jwise/aWatch2-hw/awatch2.kicad_pcb

## KiCad design awatch2.kicad_pcb (2019-01-27)

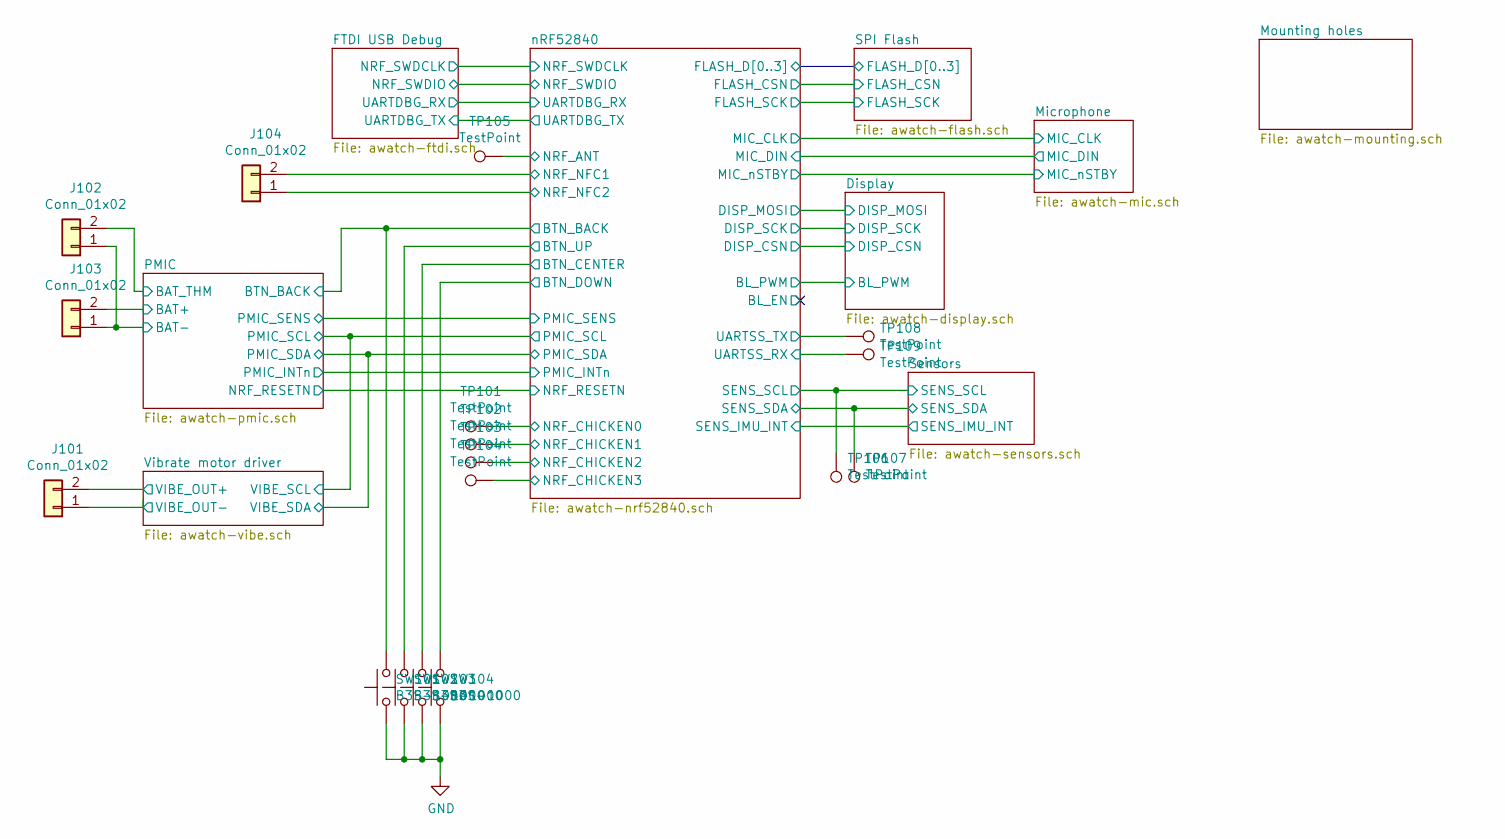
[picture p1: schematic awatch2.sch]

Parts:
J101, J102, J103, J104: Conn_01x02; PinHeader_1x02_P2.54mm_Vertical; DigiKey PN S1011EC-02-ND, S9341-ND
SW101, SW102, SW103, SW104: B3S-1000; SW_SPST_B3S-1000; DigiKey PN SW836CT-ND
TP101, TP102, TP103, TP104, TP105, TP106, TP107, TP108, TP109: TestPoint; TestPoint_Pad_D1.5mm

Connections:
/PMIC/BAT+: J103.2; also elsewhere on the board
/PMIC/BAT_THM: J102.2; also elsewhere on the board
/PMIC/BTN_BACK: SW101.2; also elsewhere on the board
/Sensors/SENS_SCL: TP106.1; also elsewhere on the board
/Sensors/SENS_SDA: TP107.1; also elsewhere on the board
/Vibrate motor driver/VIBE_OUT+: J101.2; also elsewhere on the board
/Vibrate motor driver/VIBE_OUT-: J101.1; also elsewhere on the board
/nRF52840/BTN_CENTER: SW103.2; also elsewhere on the board
/nRF52840/BTN_DOWN: SW104.2; also elsewhere on the board
/nRF52840/BTN_UP: SW102.2; also elsewhere on the board
/nRF52840/NRF_ANT: TP105.1; also elsewhere on the board
/nRF52840/NRF_CHICKEN0: TP101.1; also elsewhere on the board
/nRF52840/NRF_CHICKEN1: TP102.1; also elsewhere on the board
/nRF52840/NRF_CHICKEN2: TP103.1; also elsewhere on the board
/nRF52840/NRF_CHICKEN3: TP104.1; also elsewhere on the board
/nRF52840/NRF_NFC1: J104.2; also elsewhere on the board
/nRF52840/NRF_NFC2: J104.1; also elsewhere on the board
/nRF52840/UARTSS_RX: TP109.1; also elsewhere on the board
/nRF52840/UARTSS_TX: TP108.1; also elsewhere on the board
GND: J102.1, J103.1, SW101.1, SW102.1, SW103.1, SW104.1; also elsewhere on the board

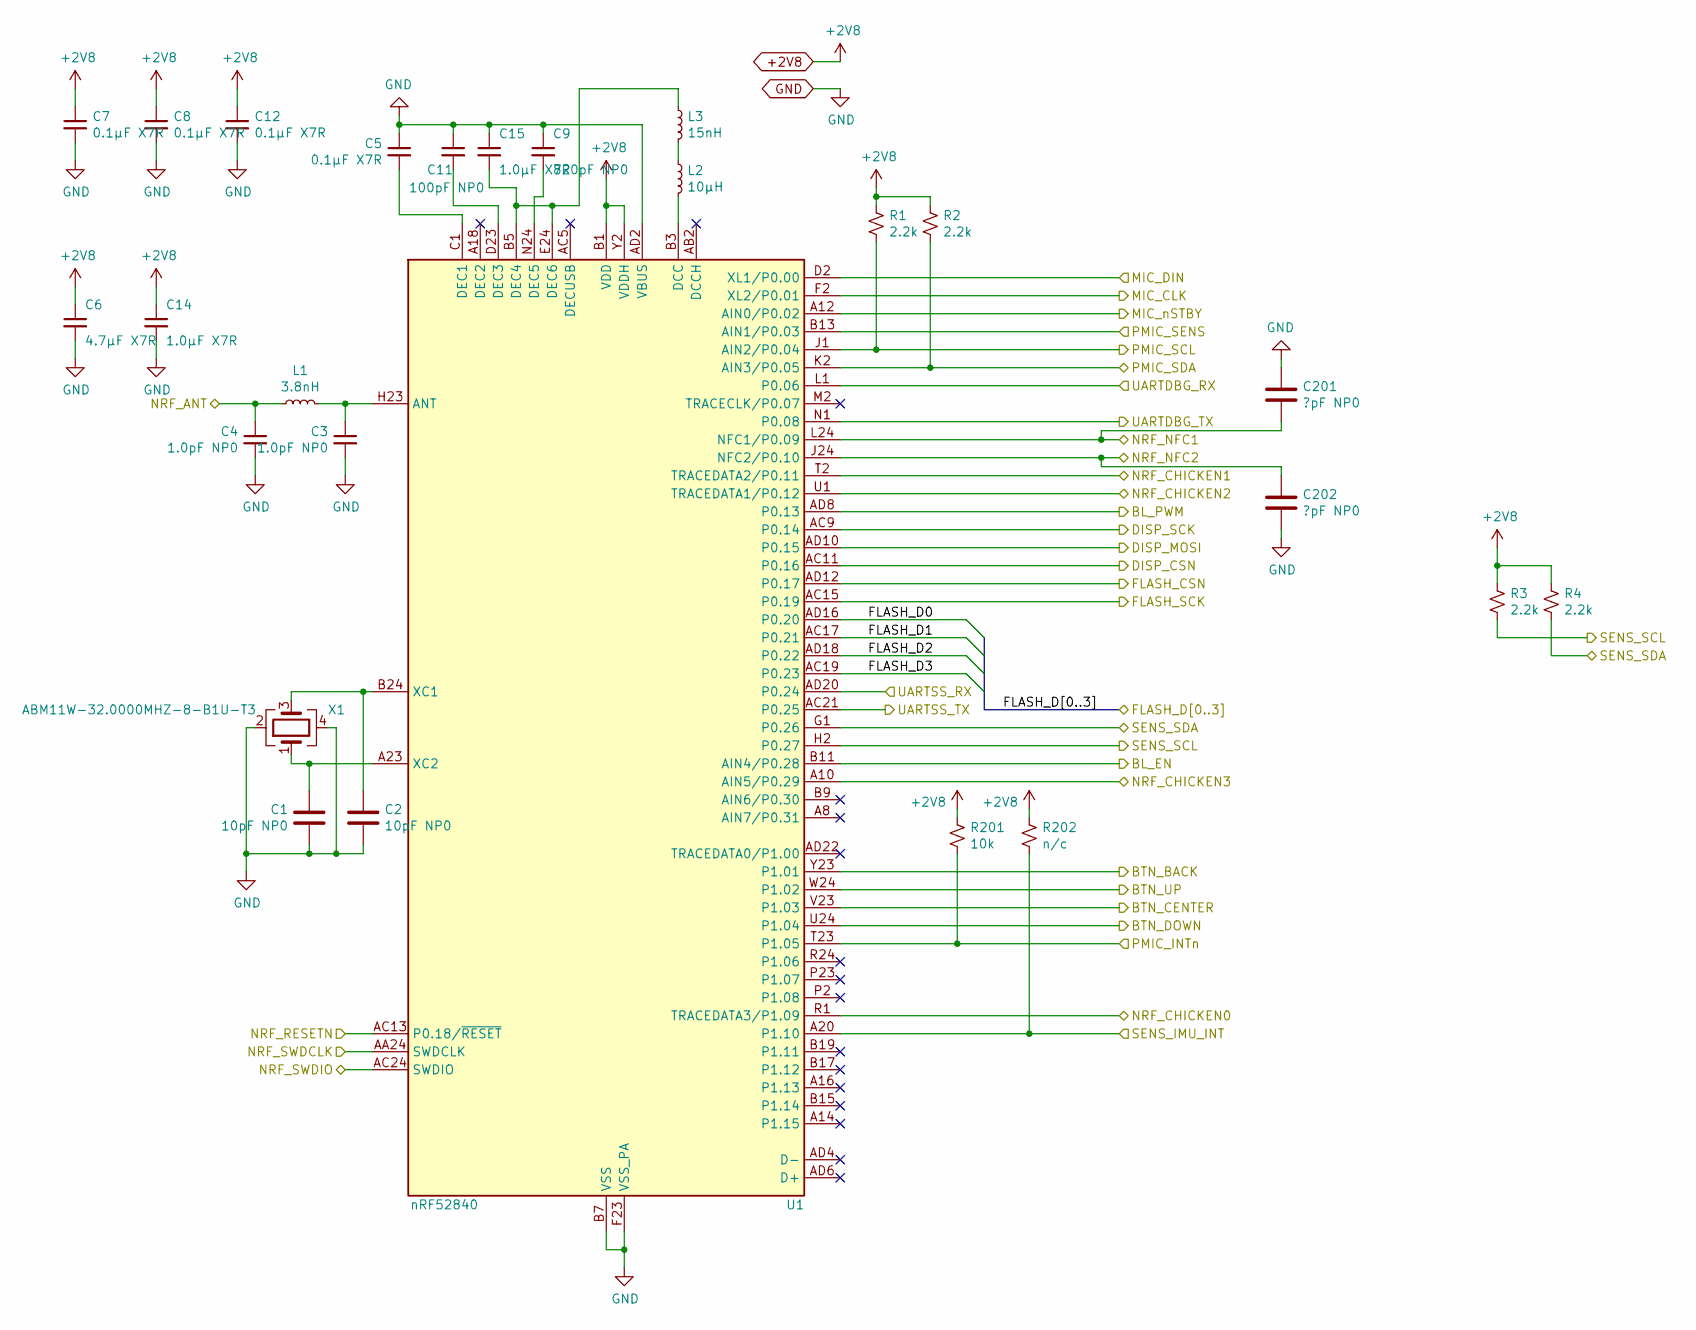
[picture p2: schematic awatch-nrf52840.sch, AWatch2]

Parts:
C1, C2: 10pF NP0; C_0603_1608Metric; DigiKey PN 311-3869-1-ND
C3, C4: 1.0pF NP0; C_0603_1608Metric; DigiKey PN 1276-1293-1-ND
C5, C7, C8, C12: 0.1µF X7R; C_0603_1608Metric; DigiKey PN 1276-1061-1-ND
C6: 4.7µF X7R; C_0603_1608Metric; DigiKey PN 1276-2087-1-ND
C9: 820pF NP0; C_0603_1608Metric; DigiKey PN 311-3959-1-ND
C11: 100pF NP0; C_0603_1608Metric; DigiKey PN 311-1069-1-ND
C14, C15: 1.0µF X7R; C_0603_1608Metric; DigiKey PN 1276-1946-1-ND
C201, C202: ?pF NP0; C_0603_1608Metric
L1: 3.8nH; L_0603_1608Metric; DigiKey PN 712-1429-1-ND
L2: 10µH; L_0603_1608Metric; DigiKey PN 445-6755-1-ND
L3: 15nH; L_0603_1608Metric; DigiKey PN CI160808-15NJCT-ND
R1, R2, R3, R4: 2.2k; R_0603_1608Metric; DigiKey PN MCT0603-2.20K-CFCT-ND
R201: 10k; R_0603_1608Metric; DigiKey PN MCT0603-10.0K-CFCT-ND
R202: n/c; R_0603_1608Metric
U1: nRF52840; Nordic_AQFN-73-1EP_7x7mm_P0.5mm; DigiKey PN 1490-1071-1-ND
X1: ABM11W-32.0000MHZ-8-B1U-T3; Crystal_SMD_2016-4Pin_2.0x1.6mm; DigiKey PN 535-13899-1-ND

Connections:
+2V8: C6.1, C7.1, C8.1, C12.1, C14.1, R1.1, R2.1, R3.1, R4.1, R201.1, R202.1, U1.A22 (VDD), U1.AD14 (VDD), U1.AD23 (VDD), U1.B1 (VDD), U1.W1 (VDD), U1.Y2 (VDDH); also elsewhere on the board
/Display/BL_PWM: U1.AD8 (P0.13); also elsewhere on the board
/Display/DISP_CSN: U1.AC11 (P0.16); also elsewhere on the board
/Display/DISP_MOSI: U1.AD10 (P0.15); also elsewhere on the board
/Display/DISP_SCK: U1.AC9 (P0.14); also elsewhere on the board
/FTDI USB Debug/NRF_SWDCLK: U1.AA24 (SWDCLK); also elsewhere on the board
/FTDI USB Debug/NRF_SWDIO: U1.AC24 (SWDIO); also elsewhere on the board
/FTDI USB Debug/UARTDBG_RX: U1.L1 (P0.06); also elsewhere on the board
/FTDI USB Debug/UARTDBG_TX: U1.N1 (P0.08); also elsewhere on the board
/Microphone/MIC_CLK: U1.F2 (XL2/P0.01); also elsewhere on the board
/Microphone/MIC_DIN: U1.D2 (XL1/P0.00); also elsewhere on the board
/Microphone/MIC_nSTBY: U1.A12 (AIN0/P0.02); also elsewhere on the board
/PMIC/BTN_BACK: U1.Y23 (P1.01); also elsewhere on the board
/PMIC/NRF_RESETN: U1.AC13 (P0.18/~RESET); also elsewhere on the board
/PMIC/PMIC_INTn: R201.2, U1.T23 (P1.05); also elsewhere on the board
/PMIC/PMIC_SCL: R1.2, U1.J1 (AIN2/P0.04); also elsewhere on the board
/PMIC/PMIC_SDA: R2.2, U1.K2 (AIN3/P0.05); also elsewhere on the board
/PMIC/PMIC_SENS: U1.B13 (AIN1/P0.03); also elsewhere on the board
/SPI Flash/FLASH_CSN: U1.AD12 (P0.17); also elsewhere on the board
/SPI Flash/FLASH_D0: U1.AD16 (P0.20); also elsewhere on the board
/SPI Flash/FLASH_D1: U1.AC17 (P0.21); also elsewhere on the board
/SPI Flash/FLASH_D2: U1.AD18 (P0.22); also elsewhere on the board
/SPI Flash/FLASH_D3: U1.AC19 (P0.23); also elsewhere on the board
/SPI Flash/FLASH_SCK: U1.AC15 (P0.19); also elsewhere on the board
/Sensors/SENS_IMU_INT: R202.2, U1.A20 (P1.10); also elsewhere on the board
/Sensors/SENS_SCL: R3.2, U1.H2 (P0.27); also elsewhere on the board
/Sensors/SENS_SDA: R4.2, U1.G1 (P0.26); also elsewhere on the board
/nRF52840/BL_EN: U1.B11 (AIN4/P0.28)
/nRF52840/BTN_CENTER: U1.V23 (P1.03); also elsewhere on the board
/nRF52840/BTN_DOWN: U1.U24 (P1.04); also elsewhere on the board
/nRF52840/BTN_UP: U1.W24 (P1.02); also elsewhere on the board
/nRF52840/NRF_ANT: C4.1, L1.1; also elsewhere on the board
/nRF52840/NRF_CHICKEN0: U1.R1 (TRACEDATA3/P1.09); also elsewhere on the board
/nRF52840/NRF_CHICKEN1: U1.T2 (TRACEDATA2/P0.11); also elsewhere on the board
/nRF52840/NRF_CHICKEN2: U1.U1 (TRACEDATA1/P0.12); also elsewhere on the board
/nRF52840/NRF_CHICKEN3: U1.A10 (AIN5/P0.29); also elsewhere on the board
/nRF52840/NRF_NFC1: C201.2, U1.L24 (NFC1/P0.09); also elsewhere on the board
/nRF52840/NRF_NFC2: C202.1, U1.J24 (NFC2/P0.10); also elsewhere on the board
/nRF52840/UARTSS_RX: U1.AD20 (P0.24); also elsewhere on the board
/nRF52840/UARTSS_TX: U1.AC21 (P0.25); also elsewhere on the board
GND: C1.2, C2.2, C3.2, C4.2, C5.1, C6.2, C7.2, C8.2, C9.1, C11.1, C12.2, C14.2, C15.1, C201.1, C202.2, U1.AD2 (VBUS), U1.B7 (VSS), U1.EP (VSS), U1.F23 (VSS_PA), X1.2, X1.4; also elsewhere on the board
unnamed: C1.1, U1.A23 (XC2), X1.1
unnamed: C2.1, U1.B24 (XC1), X1.3
unnamed: C3.1, L1.2, U1.H23 (ANT)
unnamed: C5.2, U1.C1 (DEC1)
unnamed: C9.2, U1.N24 (DEC5)
unnamed: C11.2, U1.D23 (DEC3)
unnamed: C15.2, L3.1, U1.B5 (DEC4), U1.E24 (DEC6)
unnamed: L2.1, L3.2
unnamed: L2.2, U1.B3 (DCC)

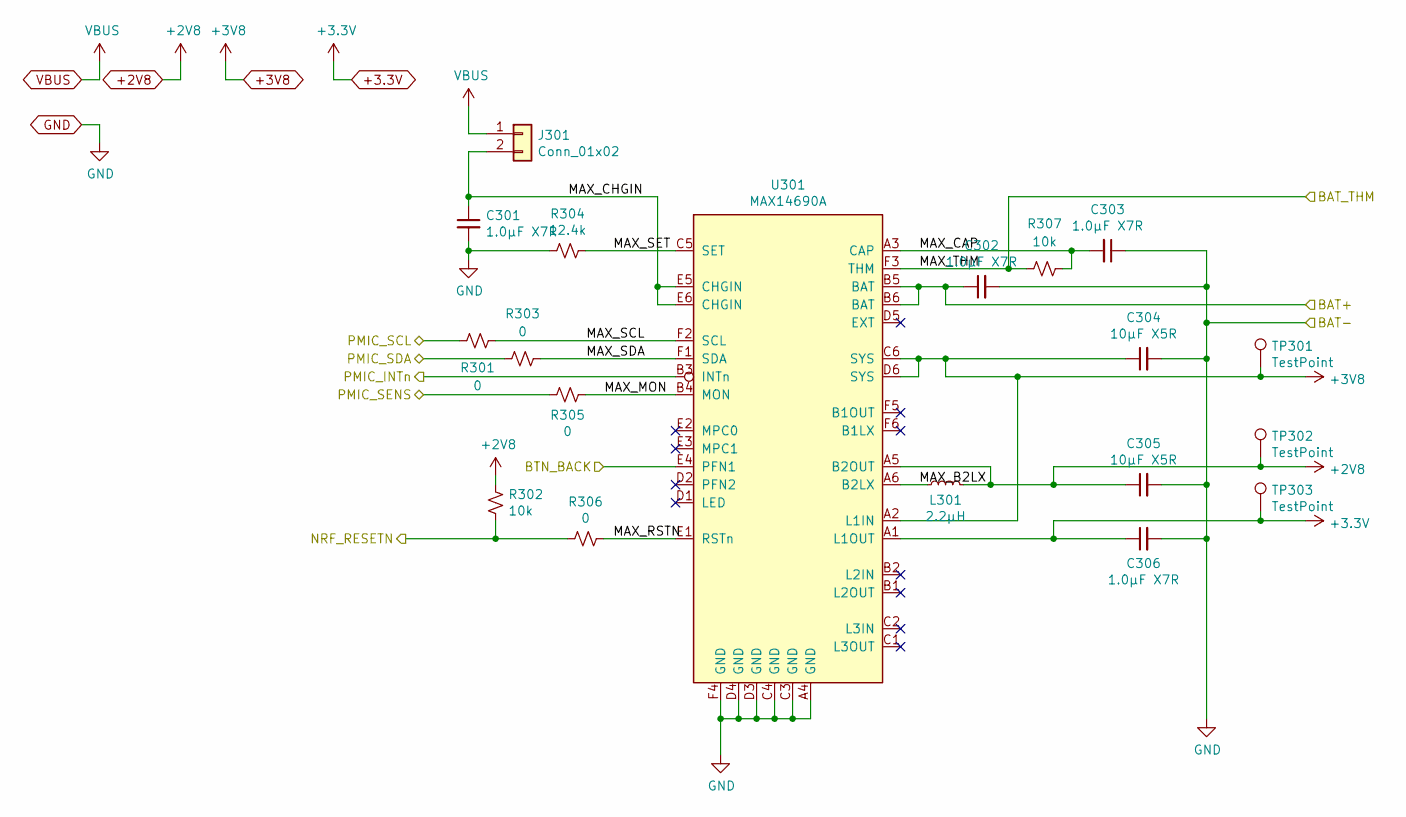
[picture p3: schematic awatch-pmic.sch, AWatch2]

Parts:
C301, C302, C303, C306: 1.0µF X7R; C_0603_1608Metric; DigiKey PN 1276-1946-1-ND
C304, C305: 10µF X5R; C_0603_1608Metric; DigiKey PN 490-12538-1-ND
J301: Conn_01x02; PinHeader_1x02_P2.54mm_Vertical; DigiKey PN S1011EC-02-ND, S9341-ND
L301: 2.2µH; L_0603_1608Metric; DigiKey PN 445-6385-1-ND
R301, R303, R305, R306: 0; R_0603_1608Metric; DigiKey PN MCT0603-0.0-ZZCT-ND
R302, R307: 10k; R_0603_1608Metric; DigiKey PN MCT0603-10.0K-CFCT-ND
R304: 12.4k; R_0603_1608Metric; DigiKey PN RNCP0603FTD12K4CT-ND
TP301, TP302, TP303: TestPoint; TestPoint_Pad_D1.5mm
U301: MAX14690A; WLP-36_2.69x2.44mm_Layout6x6_P0.4mm_Ball0.22mm_Pad0.2mm_NSMD; DigiKey PN MOUSER: 700-MAX14690AEWX+

Connections:
+2V8: C305.1, L301.2, R302.2, TP302.1, U301.A5 (B2OUT); also elsewhere on the board
+3.3V: C306.1, TP303.1, U301.A1 (L1OUT); also elsewhere on the board
+3V8: C304.1, TP301.1, U301.A2 (L1IN), U301.C6 (SYS), U301.D6 (SYS); also elsewhere on the board
/PMIC/BAT+: C302.1, U301.B5 (BAT), U301.B6 (BAT); also elsewhere on the board
/PMIC/BAT_THM: R307.2, U301.F3 (THM); also elsewhere on the board
/PMIC/BTN_BACK: U301.E4 (PFN1); also elsewhere on the board
/PMIC/MAX_B2LX: L301.1, U301.A6 (B2LX)
/PMIC/MAX_CAP: C303.2, R307.1, U301.A3 (CAP)
/PMIC/MAX_CHGIN: C301.1, J301.2, U301.E5 (CHGIN), U301.E6 (CHGIN)
/PMIC/MAX_MON: R305.1, U301.B4 (MON)
/PMIC/MAX_RSTN: R306.1, U301.E1 (RSTn)
/PMIC/MAX_SCL: R301.1, U301.F2 (SCL)
/PMIC/MAX_SDA: R303.1, U301.F1 (SDA)
/PMIC/MAX_SET: R304.1, U301.C5 (SET)
/PMIC/NRF_RESETN: R302.1, R306.2; also elsewhere on the board
/PMIC/PMIC_INTn: U301.B3 (INTn); also elsewhere on the board
/PMIC/PMIC_SCL: R301.2; also elsewhere on the board
/PMIC/PMIC_SDA: R303.2; also elsewhere on the board
/PMIC/PMIC_SENS: R305.2; also elsewhere on the board
GND: C301.2, C302.2, C303.1, C304.2, C305.2, C306.2, R304.2, U301.A4 (GND), U301.C3 (GND), U301.C4 (GND), U301.D3 (GND), U301.D4 (GND), U301.F4 (GND); also elsewhere on the board
VBUS: J301.1; also elsewhere on the board

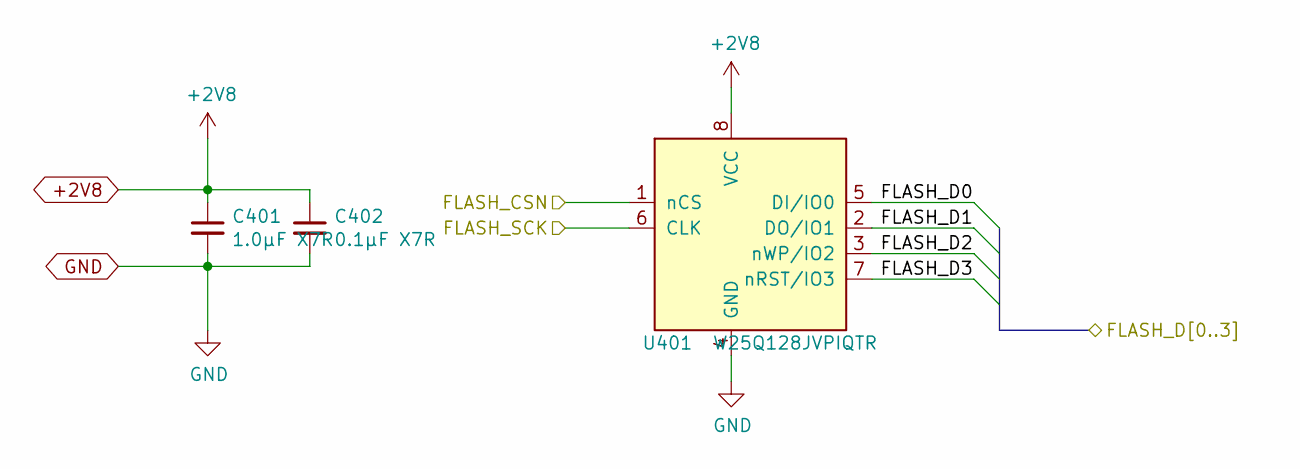
[picture p4: schematic awatch-flash.sch, AWatch2]

Parts:
C401: 1.0µF X7R; C_0603_1608Metric; DigiKey PN 1276-1946-1-ND
C402: 0.1µF X7R; C_0603_1608Metric; DigiKey PN 1276-1061-1-ND
U401: W25Q128JVPIQTR; WSON-8-1EP_6x5mm_P1.27mm_EP3.4x4mm; DigiKey PN W25Q128JVPIQCT-ND

Connections:
+2V8: C401.1, C402.1, U401.8 (VCC); also elsewhere on the board
/SPI Flash/FLASH_CSN: U401.1 (nCS); also elsewhere on the board
/SPI Flash/FLASH_D0: U401.5 (DI/IO0); also elsewhere on the board
/SPI Flash/FLASH_D1: U401.2 (DO/IO1); also elsewhere on the board
/SPI Flash/FLASH_D2: U401.3 (nWP/IO2); also elsewhere on the board
/SPI Flash/FLASH_D3: U401.7 (nRST/IO3); also elsewhere on the board
/SPI Flash/FLASH_SCK: U401.6 (CLK); also elsewhere on the board
GND: C401.2, C402.2, U401.4 (GND); also elsewhere on the board

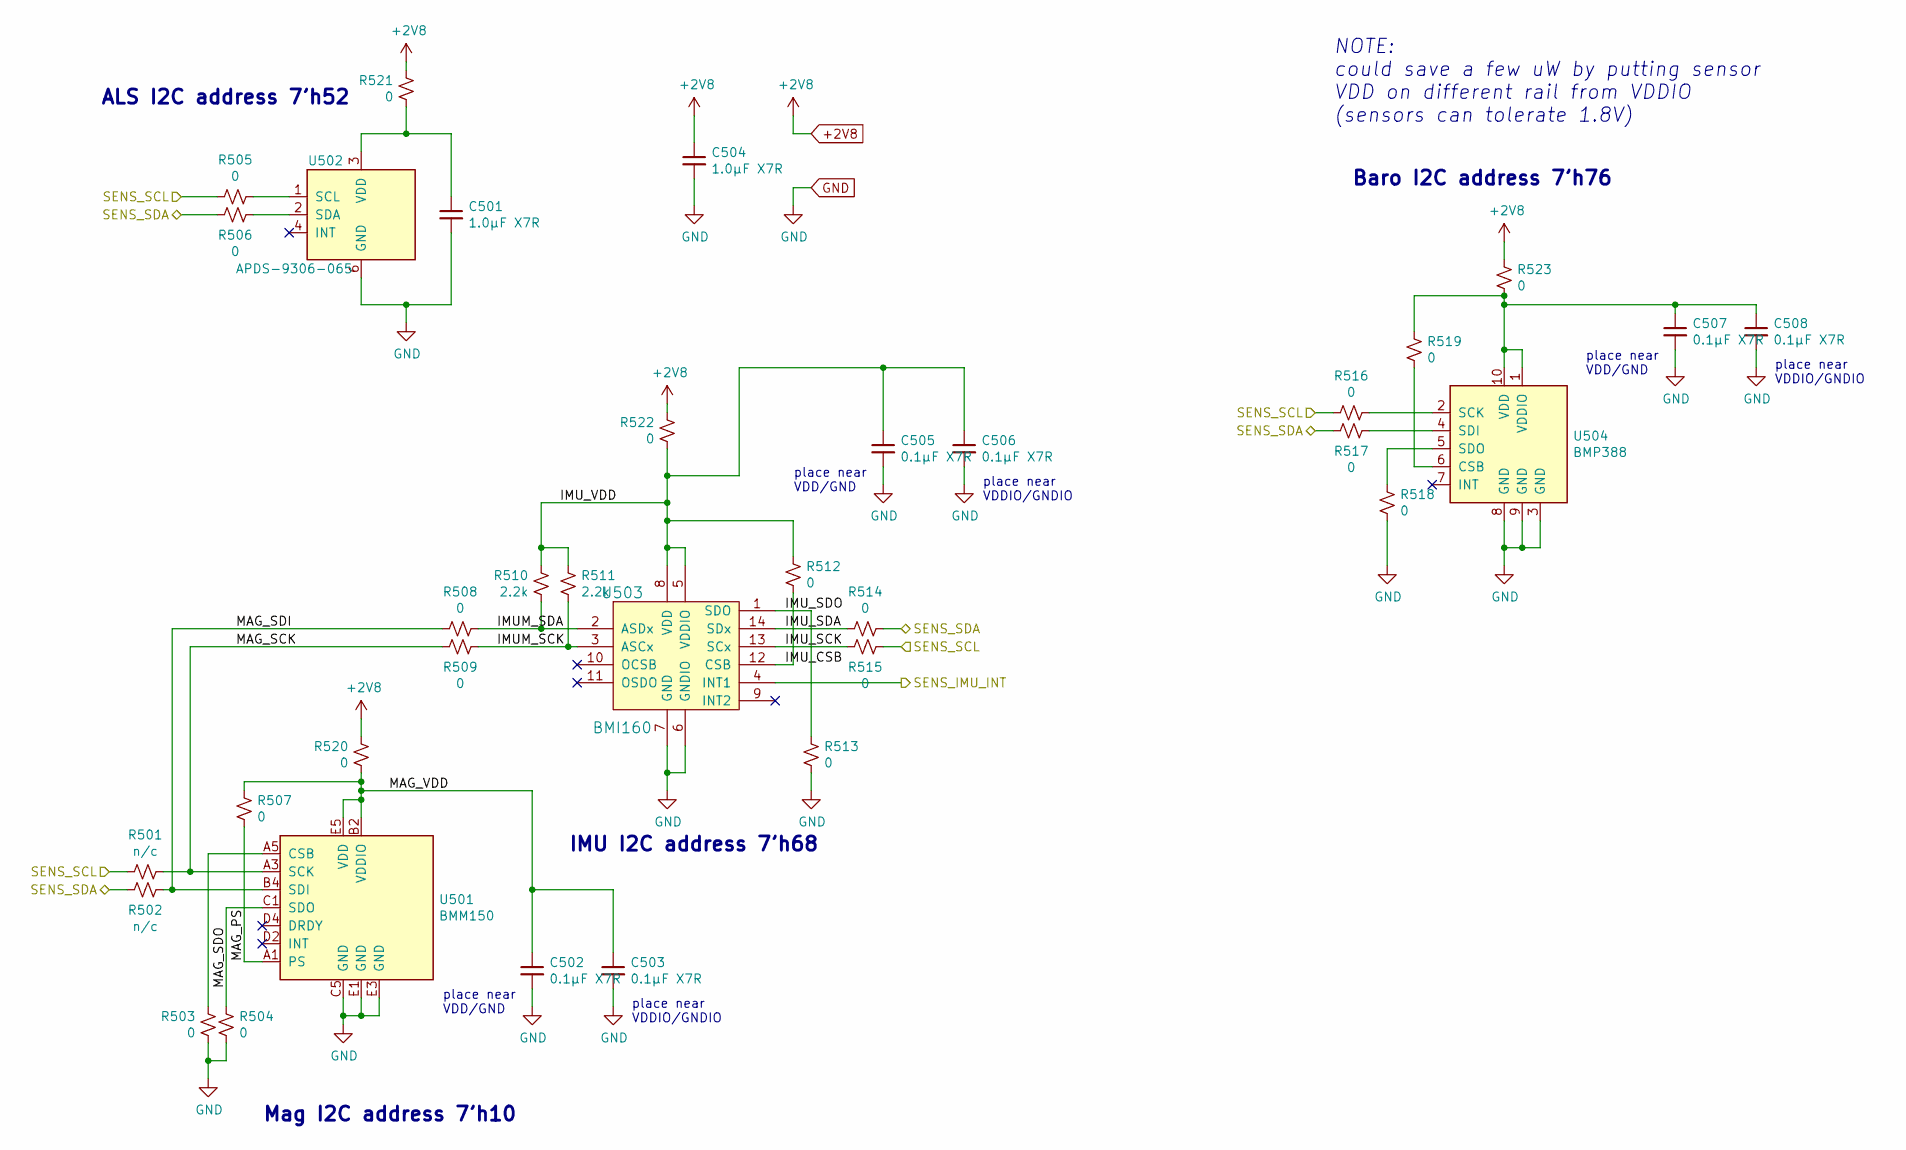
[picture p5: schematic awatch-sensors.sch, AWatch2]

Parts:
C501, C504: 1.0µF X7R; C_0603_1608Metric; DigiKey PN 1276-1946-1-ND
C502, C503, C505, C506, C507, C508: 0.1µF X7R; C_0603_1608Metric; DigiKey PN 1276-1061-1-ND
R501, R502: n/c; R_0603_1608Metric
R503, R504, R505, R506, R507, R508, R509, R512, R513, R514, R515, R516, R517, R518, R519, R520, R521, R522, R523: 0; R_0603_1608Metric; DigiKey PN MCT0603-0.0-ZZCT-ND
R510, R511: 2.2k; R_0603_1608Metric; DigiKey PN MCT0603-2.20K-CFCT-ND
U501: BMM150; WLCSP-12_1.56x1.56mm_Layout5x5_P0.283mm_Ball0.25mm_Pad0.2mm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; DigiKey PN 828-1044-1-ND
U502: APDS-9306-065; DFN-6_2x2mm_P0.53mm; DigiKey PN 516-3578-1-ND
U503: BMI160; DigiKey PN 828-1057-1-ND
U504: BMP388; DigiKey PN 828-1079-1-ND

Connections:
+2V8: C504.1, R520.2, R521.2, R522.2, R523.2; also elsewhere on the board
/Sensors/IMUM_SCK: R509.1, R511.2, U503.3 (ASCx)
/Sensors/IMUM_SDA: R508.1, R510.2, U503.2 (ASDx)
/Sensors/IMU_CSB: R512.1, U503.12 (CSB)
/Sensors/IMU_SCK: R515.2, U503.13 (SCx)
/Sensors/IMU_SDA: R514.2, U503.14 (SDx)
/Sensors/IMU_SDO: R513.2, U503.1 (SDO)
/Sensors/IMU_VDD: C505.1, C506.1, R510.1, R511.1, R512.2, R522.1, U503.5 (VDDIO), U503.8 (VDD)
/Sensors/MAG_PS: R507.1, U501.A1 (PS)
/Sensors/MAG_SCK: R501.1, R509.2, U501.A3 (SCK)
/Sensors/MAG_SDI: R502.1, R508.2, U501.B4 (SDI)
/Sensors/MAG_SDO: R504.2, U501.C1 (SDO)
/Sensors/MAG_VDD: C502.1, C503.1, R507.2, R520.1, U501.B2 (VDDIO), U501.E5 (VDD)
/Sensors/SENS_IMU_INT: U503.4 (INT1); also elsewhere on the board
/Sensors/SENS_SCL: R501.2, R505.2, R515.1, R516.2; also elsewhere on the board
/Sensors/SENS_SDA: R502.2, R506.2, R514.1, R517.2; also elsewhere on the board
GND: C501.2, C502.2, C503.2, C504.2, C505.2, C506.2, C507.2, C508.2, R503.1, R504.1, R513.1, R518.1, U501.C5 (GND), U501.E1 (GND), U501.E3 (GND), U502.6 (GND), U503.6 (GNDIO), U503.7 (GND), U504.3 (GND), U504.8 (GND), U504.9 (GND); also elsewhere on the board
unnamed: C501.1, R521.1, U502.3 (VDD)
unnamed: C507.1, C508.1, R519.2, R523.1, U504.1 (VDDIO), U504.10 (VDD)
unnamed: R503.2, U501.A5 (CSB)
unnamed: R505.1, U502.1 (SCL)
unnamed: R506.1, U502.2 (SDA)
unnamed: R516.1, U504.2 (SCK)
unnamed: R517.1, U504.4 (SDI)
unnamed: R518.2, U504.5 (SDO)
unnamed: R519.1, U504.6 (CSB)

Notes on the sheet:
ALS I2C address 7’h52
place near VDDIO/GNDIO
place near VDD/GND
Mag I2C address 7’h10
IMU I2C address 7’h68
Baro I2C address 7’h76
NOTE: could save a few uW by putting sensor VDD on different rail from VDDIO (sensors can tolerate 1.8V)

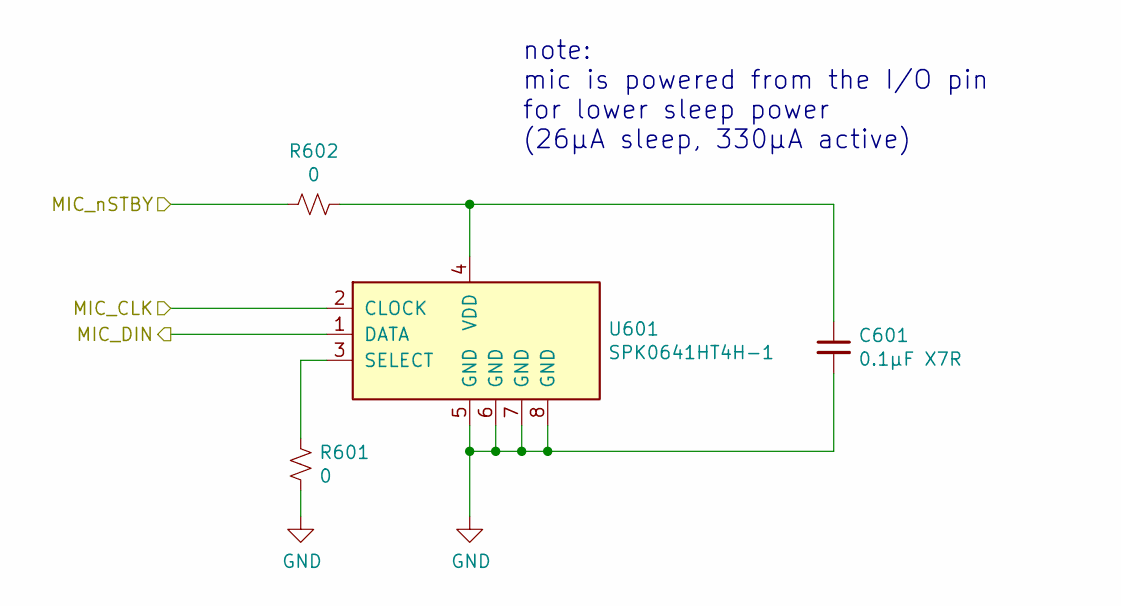
[picture p6: schematic awatch-mic.sch, AWatch2]

Parts:
C601: 0.1µF X7R; C_0603_1608Metric; DigiKey PN 1276-1061-1-ND
R601, R602: 0; R_0603_1608Metric; DigiKey PN MCT0603-0.0-ZZCT-ND
U601: SPK0641HT4H-1; SPK0641HT4H; DigiKey PN 423-1425-1-ND

Connections:
/Microphone/MIC_CLK: U601.2 (CLOCK); also elsewhere on the board
/Microphone/MIC_DIN: U601.1 (DATA); also elsewhere on the board
/Microphone/MIC_nSTBY: R602.2; also elsewhere on the board
GND: C601.2, R601.1, U601.5 (GND), U601.6 (GND), U601.7 (GND), U601.8 (GND); also elsewhere on the board
unnamed: C601.1, R602.1, U601.4 (VDD)
unnamed: R601.2, U601.3 (SELECT)

Notes on the sheet:
note: mic is powered from the I/O pin for lower sleep power (26µA sleep, 330µA active)

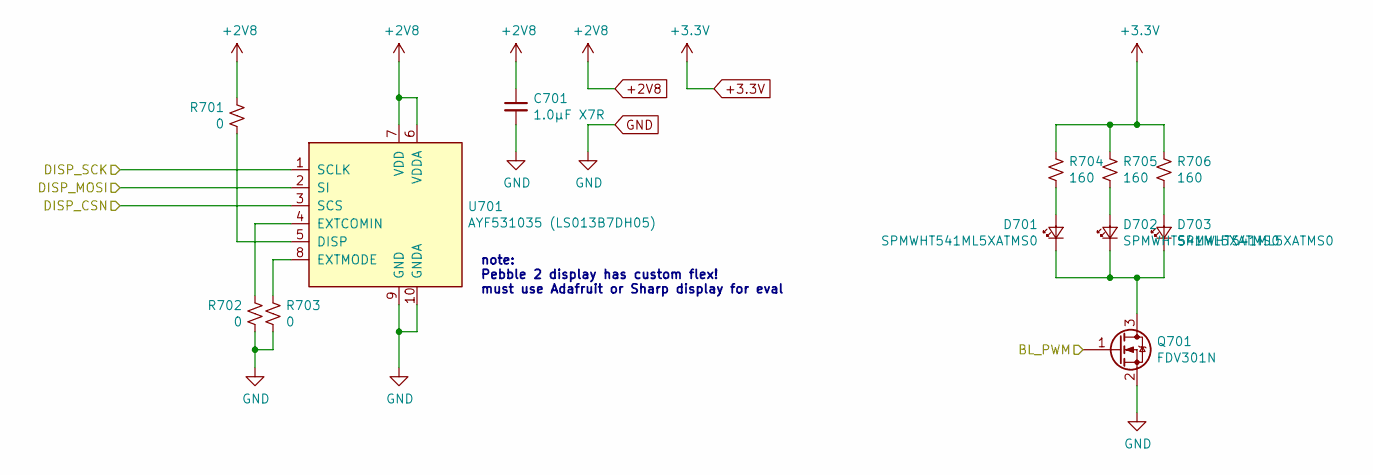
[picture p7: schematic awatch-display.sch, AWatch2]

Parts:
C701: 1.0µF X7R; C_0603_1608Metric; DigiKey PN 1276-1946-1-ND
D701, D702, D703: SPMWHT541ML5XATMS0; LED_PLCC_2835_Handsoldering; DigiKey PN 1510-1284-1-ND
Q701: FDV301N; SOT-23; DigiKey PN FDV301NCT-ND
R701, R702, R703: 0; R_0603_1608Metric; DigiKey PN MCT0603-0.0-ZZCT-ND
R704, R705, R706: 160; R_0603_1608Metric; DigiKey PN 749-1765-1-ND
U701: AYF531035 (LS013B7DH05); Panasonic_Y5B_AYF531035_1x10-1MP_P0.50mm_Horizontal; DigiKey PN 255-5667-ND, Adafruit display

Connections:
+2V8: C701.1, R701.1, U701.6 (VDDA), U701.7 (VDD); also elsewhere on the board
+3.3V: R704.1, R705.1, R706.1; also elsewhere on the board
/Display/BL_PWM: Q701.1 (G); also elsewhere on the board
/Display/DISP_CSN: U701.3 (SCS); also elsewhere on the board
/Display/DISP_MOSI: U701.2 (SI); also elsewhere on the board
/Display/DISP_SCK: U701.1 (SCLK); also elsewhere on the board
GND: C701.2, Q701.2 (S), R702.2, R703.2, U701.9 (GND), U701.10 (GNDA); also elsewhere on the board
unnamed: D701.1 (K), D702.1 (K), D703.1 (K), Q701.3 (D)
unnamed: D701.2 (A), R704.2
unnamed: D702.2 (A), R705.2
unnamed: D703.2 (A), R706.2
unnamed: R701.2, U701.5 (DISP)
unnamed: R702.1, U701.4 (EXTCOMIN)
unnamed: R703.1, U701.8 (EXTMODE)

Notes on the sheet:
note: Pebble 2 display has custom flex! must use Adafruit or Sharp display for eval

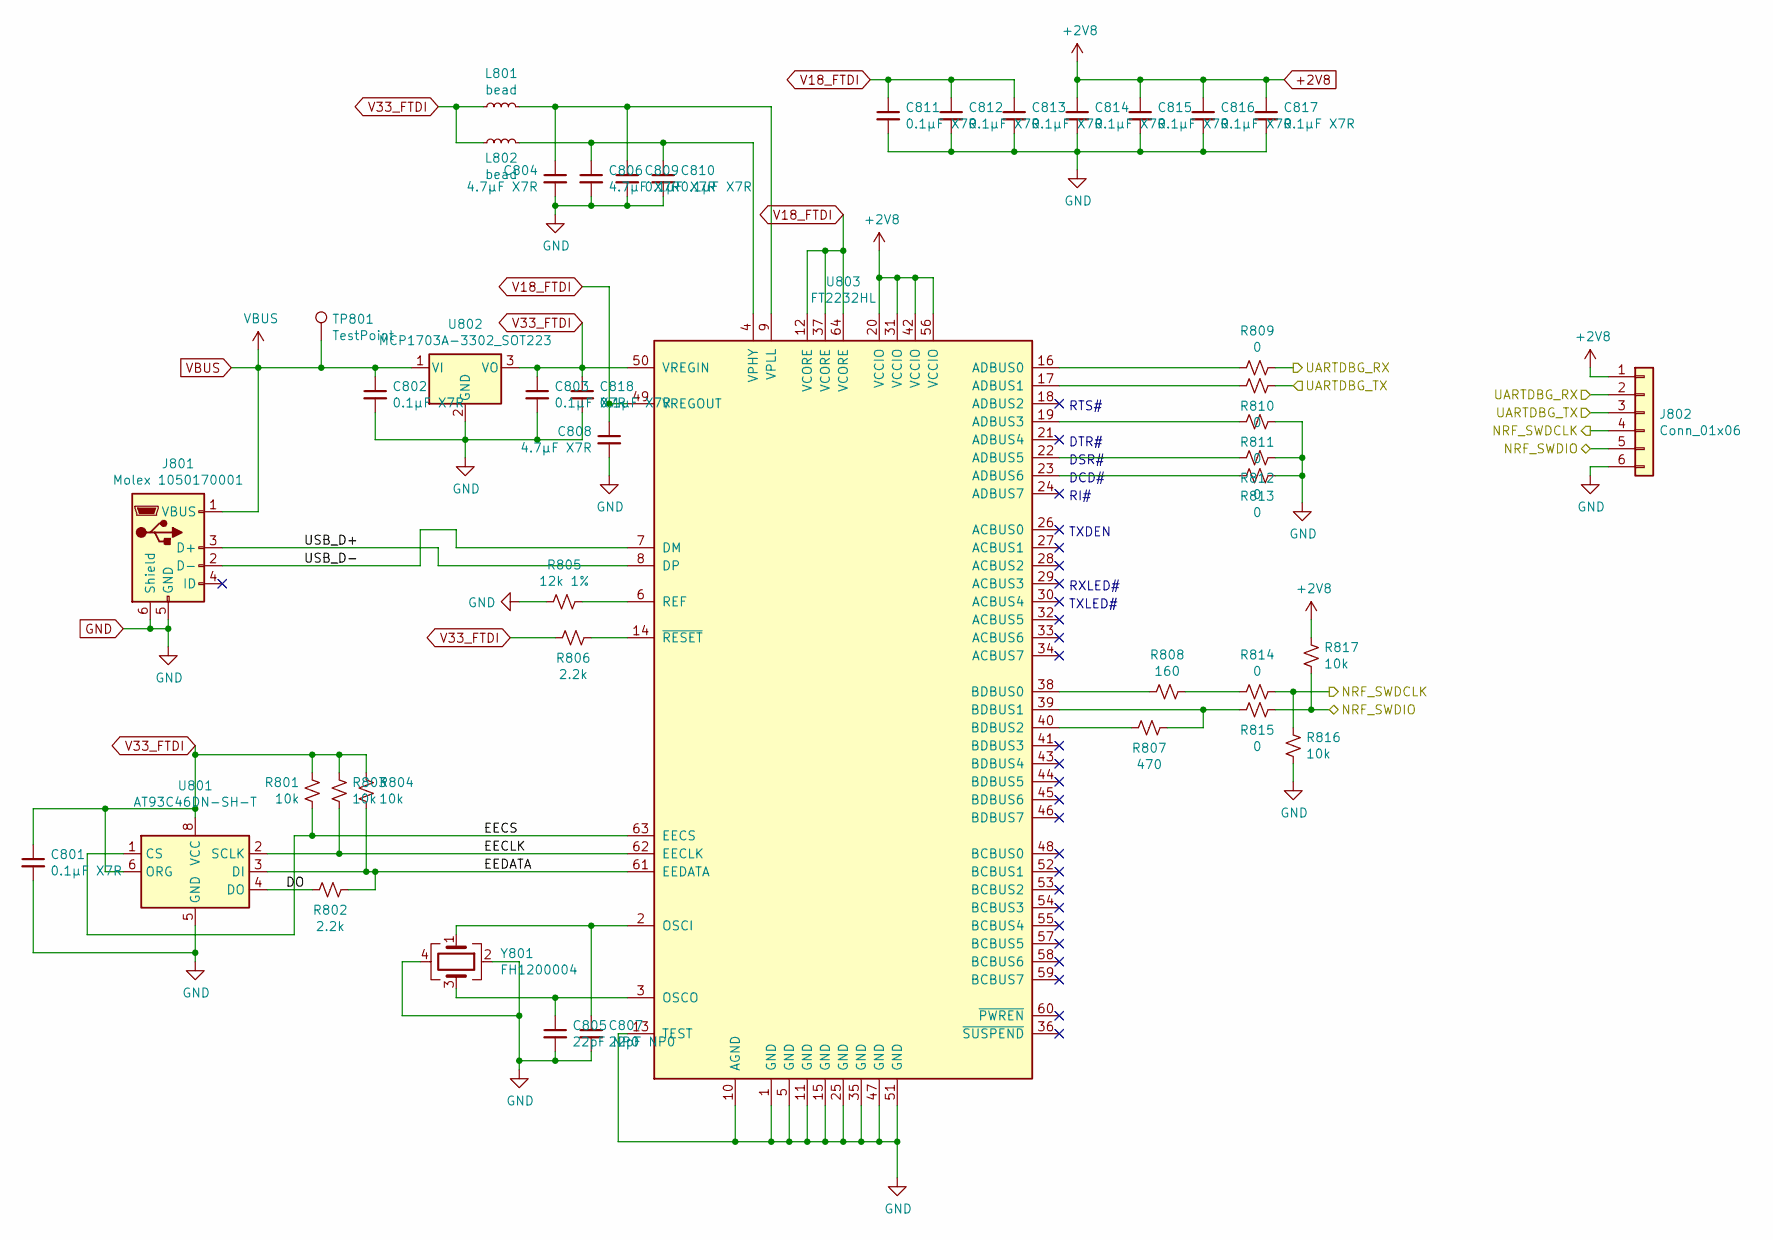
[picture p8: schematic awatch-ftdi.sch, AWatch2]

Parts:
C801, C802, C803, C809, C810, C811, C812, C813, C814, C815, C816, C817, C818: 0.1µF X7R; C_0603_1608Metric; DigiKey PN 1276-1061-1-ND
C804, C806, C808: 4.7µF X7R; C_0603_1608Metric; DigiKey PN 1276-2087-1-ND
C805, C807: 22pF NP0; C_0603_1608Metric; DigiKey PN 399-7874-1-ND
J801: Molex 1050170001; USB_Micro-B_Molex-105017-0001; DigiKey PN WM1399CT-ND
J802: Conn_01x06; PinHeader_1x06_P2.54mm_Vertical; DigiKey PN S1011EC-06-ND
L801, L802: bead; L_0603_1608Metric; DigiKey PN 587-1926-1-ND
R801, R803, R804, R816, R817: 10k; R_0603_1608Metric; DigiKey PN MCT0603-10.0K-CFCT-ND
R802, R806: 2.2k; R_0603_1608Metric; DigiKey PN MCT0603-2.20K-CFCT-ND
R805: 12k 1%; R_0603_1608Metric; DigiKey PN MCT0603-12.0K-CFCT-ND
R807: 470; R_0603_1608Metric; DigiKey PN MCT0603-470-CFCT-ND
R808: 160; R_0603_1608Metric; DigiKey PN 749-1765-1-ND
R809, R810, R811, R812, R813, R814, R815: 0; R_0603_1608Metric; DigiKey PN MCT0603-0.0-ZZCT-ND
TP801: TestPoint; TestPoint_Pad_D1.5mm
U801: AT93C46DN-SH-T; SOIC-8_3.9x4.9mm_P1.27mm; DigiKey PN AT93C46DN-SH-TCT-ND AT93C46DN-SH-TCT-ND
U802: MCP1703A-3302_SOT223; SOT-223-3_TabPin2; DigiKey PN MCP1703AT-3302E/DBCT-ND
U803: FT2232HL; LQFP-64_10x10mm_P0.5mm; DigiKey PN 768-1024-1-ND
Y801: FH1200004; Crystal_SMD_2520-4Pin_2.5x2.0mm; DigiKey PN FH1200004CT-ND

Connections:
+2V8: C814.1, C815.1, C816.1, C817.1, J802.1, R817.2, U803.20 (VCCIO), U803.31 (VCCIO), U803.42 (VCCIO), U803.56 (VCCIO); also elsewhere on the board
/FTDI USB Debug/DO: R802.2, U801.4 (DO)
/FTDI USB Debug/EECLK: R803.1, U801.2 (SCLK), U803.62 (EECLK)
/FTDI USB Debug/EECS: R801.1, U801.1 (CS), U803.63 (EECS)
/FTDI USB Debug/EEDATA: R802.1, R804.1, U801.3 (DI), U803.61 (EEDATA)
/FTDI USB Debug/NRF_SWDCLK: J802.4, R814.1, R816.2; also elsewhere on the board
/FTDI USB Debug/NRF_SWDIO: J802.5, R815.1, R817.1; also elsewhere on the board
/FTDI USB Debug/UARTDBG_RX: J802.2, R809.1; also elsewhere on the board
/FTDI USB Debug/UARTDBG_TX: J802.3, R810.1; also elsewhere on the board
/FTDI USB Debug/USB_D+: J801.3 (D+), U803.8 (DP)
/FTDI USB Debug/USB_D-: J801.2 (D-), U803.7 (DM)
GND: C801.2, C802.2, C803.2, C804.2, C805.2, C806.2, C807.2, C808.2, C809.2, C810.2, C811.2, C812.2, C813.2, C814.2, C815.2, C816.2, C817.2, C818.2, J801.5 (GND), J801.6 (Shield), J802.6, R805.1, R811.2, R812.2, R813.2, R816.1, U801.5 (GND), U802.2 (GND), U803.1 (GND), U803.5 (GND), U803.10 (AGND), U803.11 (GND), U803.13 (TEST), U803.15 (GND), U803.25 (GND), U803.35 (GND), U803.47 (GND), U803.51 (GND), Y801.2, Y801.4; also elsewhere on the board
unnamed: C804.1, C809.1, L801.2, U803.9 (VPLL)
unnamed: C805.1, U803.3 (OSCO), Y801.3
unnamed: C806.1, C810.1, L802.2, U803.4 (VPHY)
unnamed: C807.1, U803.2 (OSCI), Y801.1
unnamed: R805.2, U803.6 (REF)
unnamed: R806.2, U803.14 (~RESET)
unnamed: R807.1, R815.2, U803.39 (BDBUS1)
unnamed: R807.2, U803.40 (BDBUS2)
unnamed: R808.1, R814.2
unnamed: R808.2, U803.38 (BDBUS0)
unnamed: R809.2, U803.16 (ADBUS0)
unnamed: R810.2, U803.17 (ADBUS1)
unnamed: R811.1, U803.19 (ADBUS3)
unnamed: R812.1, U803.22 (ADBUS5)
unnamed: R813.1, U803.23 (ADBUS6)
V18_FTDI: C808.1, C811.1, C812.1, C813.1, U803.12 (VCORE), U803.37 (VCORE), U803.49 (VREGOUT), U803.64 (VCORE)
V33_FTDI: C801.1, C803.1, C818.1, L801.1, L802.1, R801.2, R803.2, R804.2, R806.1, U801.6 (ORG), U801.8 (VCC), U802.3 (VO), U803.50 (VREGIN)
VBUS: C802.1, J801.1 (VBUS), TP801.1, U802.1 (VI); also elsewhere on the board

Notes on the sheet:
RTS#
DTR#
DSR#
DCD#
RI#
TXDEN
RXLED#
TXLED#

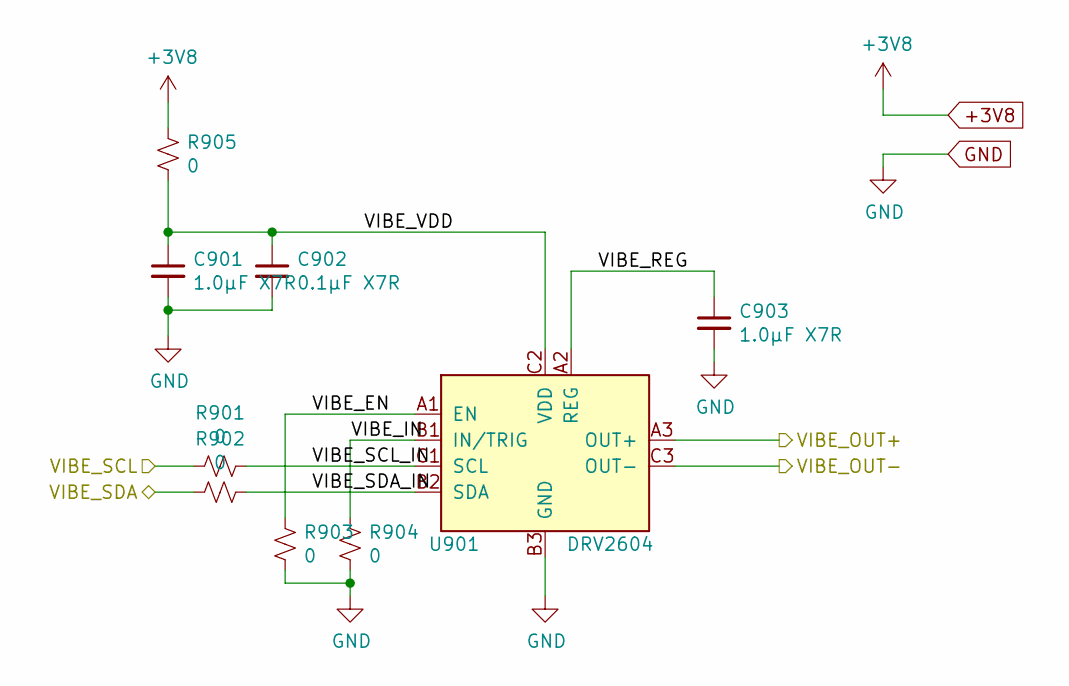
[picture p9: schematic awatch-vibe.sch, AWatch2]

Parts:
C901, C903: 1.0µF X7R; C_0603_1608Metric; DigiKey PN 1276-1946-1-ND
C902: 0.1µF X7R; C_0603_1608Metric; DigiKey PN 1276-1061-1-ND
R901, R902, R903, R904, R905: 0; R_0603_1608Metric; DigiKey PN MCT0603-0.0-ZZCT-ND
U901: DRV2604; Texas_DSBGA-9_1.47x1.47mm_Layout3x3_P0.5mm_NSMD; DigiKey PN 296-45407-1-ND

Connections:
+3V8: R905.2; also elsewhere on the board
/PMIC/PMIC_SCL: R901.2; also elsewhere on the board
/PMIC/PMIC_SDA: R902.2; also elsewhere on the board
/Vibrate motor driver/VIBE_EN: R903.2, U901.A1 (EN)
/Vibrate motor driver/VIBE_IN: R904.2, U901.B1 (IN/TRIG)
/Vibrate motor driver/VIBE_OUT+: U901.A3 (OUT+); also elsewhere on the board
/Vibrate motor driver/VIBE_OUT-: U901.C3 (OUT-); also elsewhere on the board
/Vibrate motor driver/VIBE_REG: C903.1, U901.A2 (REG)
/Vibrate motor driver/VIBE_SCL_IN: R901.1, U901.C1 (SCL)
/Vibrate motor driver/VIBE_SDA_IN: R902.1, U901.B2 (SDA)
/Vibrate motor driver/VIBE_VDD: C901.1, C902.1, R905.1, U901.C2 (VDD)
GND: C901.2, C902.2, C903.2, R903.1, R904.1, U901.B3 (GND); also elsewhere on the board

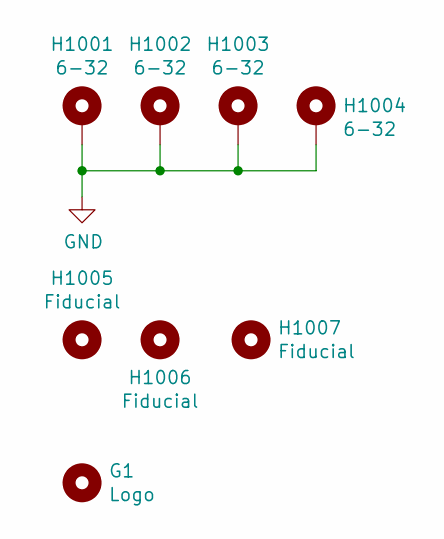
[picture p10: schematic awatch-mounting.sch]

Parts:
G1: Logo; littlehatguy
H1001, H1002, H1003, H1004: 6-32
H1005, H1006, H1007: Fiducial; Fiducial_0.5mm_Dia_1mm_Outer

Connections:
GND: H1001.1, H1002.1, H1003.1, H1004.1; also elsewhere on the board
