jwise/aWatch2-hw/awatch2.kicad_pcb

## KiCad design awatch2.kicad_pcb (continued)

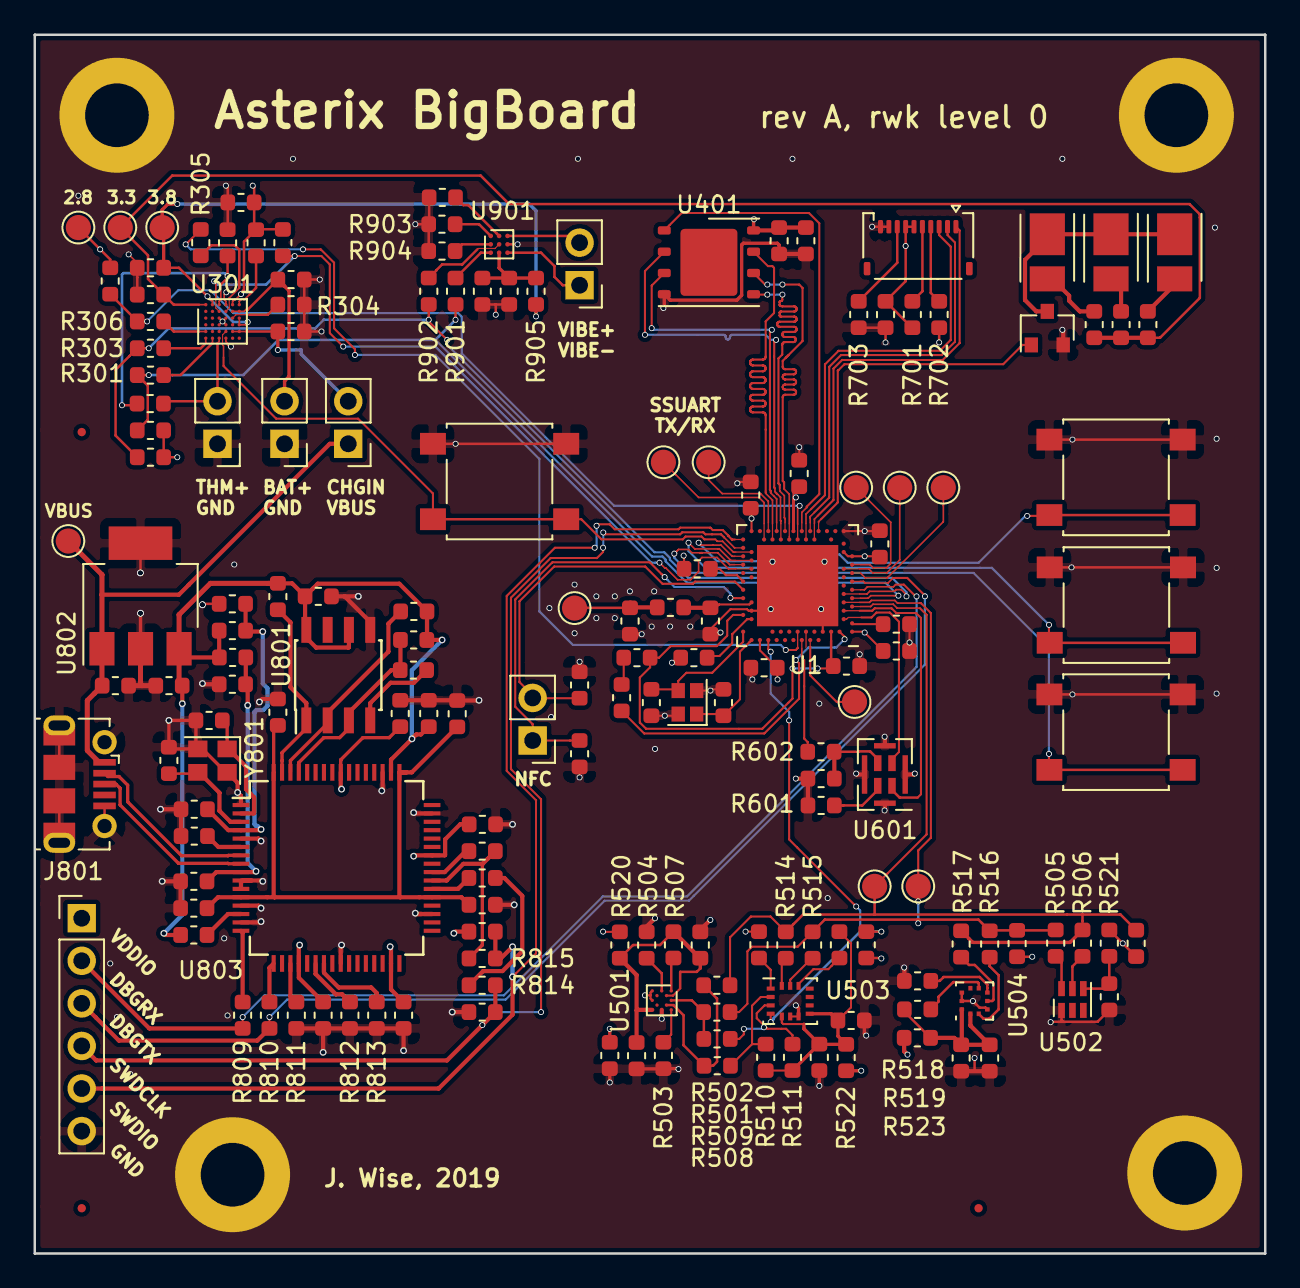
[picture p11: board awatch2.kicad_pcb from above]

Board: 4 copper layers, 73.4 x 72.7 mm, 177 parts (1 on the bottom side), 123 nets.
