jwise/aWatch2-hw/(commit log)

2018-12-30 aWatch2: initial import with nRF, PMIC, and Flash
    [awatch-flash.sch, awatch-nrf52840.sch, awatch-pmic.sch, awatch-sensors.sch, awatch2.kicad_pcb, awatch2.sch]
2018-12-30 add current design notes
2018-12-30 add sensors
    [awatch-nrf52840.sch, awatch-sensors.sch, awatch2.sch]
2018-12-30 add mic
    [awatch-flash.sch, awatch-mic.sch, awatch-nrf52840.sch, awatch-pmic.sch, awatch-sensors.sch, awatch2.sch]
2018-12-30 Add display. Add +3.3V LDO for backlight.
    [awatch-display.sch, awatch-flash.sch, awatch-mic.sch, awatch-nrf52840.sch, awatch-pmic.sch, awatch-sensors.sch, awatch2.sch]
2018-12-30 backlight PWM through a FET
    [awatch-display.sch, awatch2.sch]
2018-12-30 add FTDI
    [awatch-display.sch, awatch-flash.sch, awatch-ftdi.sch, awatch-mic.sch, awatch-nrf52840.sch, awatch-pmic.sch, awatch-sensors.sch, awatch2.sch]
2018-12-30 add vibrate
    [awatch-display.sch, awatch-flash.sch, awatch-ftdi.sch, awatch-mic.sch, awatch-nrf52840.sch, awatch-pmic.sch, awatch-sensors.sch, awatch-vibe.sch]
2018-12-30 annotate all
    [awatch-display.sch, awatch-flash.sch, awatch-ftdi.sch, awatch-mic.sch, awatch-nrf52840.sch, awatch-pmic.sch, awatch-sensors.sch, awatch-vibe.sch]
2018-12-30 add power measurement cuts
    [awatch-sensors.sch, awatch-vibe.sch]
2018-12-30 update xtal caps on FTDI
    [awatch-ftdi.sch]
2019-01-02 Add footprints.
    [awatch-display.sch, awatch-flash.sch, awatch-ftdi.sch, awatch-mic.sch, awatch-nrf52840.sch, awatch-pmic.sch, awatch-sensors.sch, awatch-vibe.sch]
2019-01-02 add BOM part for connector for display
    [awatch-display.sch]
2019-01-02 add ground pin for DRV2604
2019-01-03 FTDI placement
    [awatch-ftdi.sch, awatch-vibe.sch, awatch2.kicad_pcb]
2019-01-03 Route FTDI.
    [awatch-ftdi.sch, awatch2.kicad_pcb]
2019-01-04 PMIC relative placement and routing
    [awatch-pmic.sch, awatch2.kicad_pcb, awatch2.sch]
2019-01-04 place and route ambient light sensor
    [awatch2.kicad_pcb]
2019-01-04 Place and route pressure sensor.
    [awatch-sensors.sch, awatch2.kicad_pcb]
2019-01-04 IMU and magnetometer placed and routed
    [awatch-sensors.sch, awatch2.kicad_pcb]
2019-01-04 placed and routed all four sensors
    [awatch2.kicad_pcb]
2019-01-06 vibe, mic, display P&R
    [awatch-vibe.sch, awatch2.kicad_pcb]
2019-01-06 relative placement and routing for nRF52840
    [awatch-nrf52840.sch, awatch2.kicad_pcb]
2019-01-06 place PMIC and vibrate driver
    [awatch2.kicad_pcb]
2019-01-06 place PMIC I2C pullups
    [awatch2.kicad_pcb]
2019-01-11 Pseudofinal placement.
    [awatch2.kicad_pcb]
2019-01-13 route NFC
    [awatch-nrf52840.sch, awatch2.kicad_pcb]
2019-01-15 nRF pinout changes for routability
    [awatch-nrf52840.sch, awatch2.kicad_pcb]
2019-01-15 some PMIC and sensor routing
    [awatch-nrf52840.sch, awatch2.kicad_pcb]
2019-01-16 fully routed
    [awatch-nrf52840.sch, awatch2.kicad_pcb]
2019-01-16 passes DRC; top and bottom ground planes added
    [awatch2.kicad_pcb]
2019-01-16 update solder mask clearance for oshpark
    [awatch2.kicad_pcb]
2019-01-17 mounting holes, fiducials
    [awatch2.kicad_pcb]
2019-01-17 oops, connect the rest of the grounds
    [awatch2.kicad_pcb]
2019-01-19 approx. final layout
    [awatch-display.sch, awatch-flash.sch, awatch-ftdi.sch, awatch-mic.sch, awatch-mounting.sch, awatch-nrf52840.sch, awatch-pmic.sch, awatch-sensors.sch]
2019-01-20 BOM fully populated
    [awatch-display.sch, awatch-ftdi.sch, awatch-mic.sch, awatch-nrf52840.sch, awatch-pmic.sch, awatch-sensors.sch, awatch-vibe.sch, awatch2.sch]
2019-01-20 update values in pcb
    [awatch2.kicad_pcb]
2019-01-27 Add BOMs
    [awatch2-bom.csv, awatch2.kicad_pcb]
2019-03-18 board checkout update
